Yourm5m5/Homedeck/pcb/pcb.png

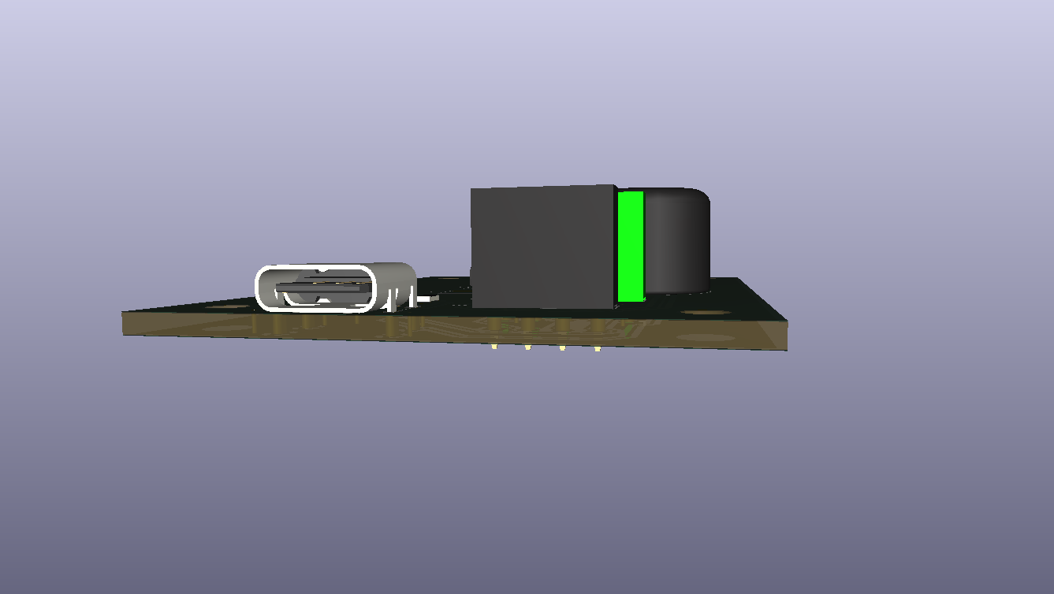
pcb/pcb.png
