Yourm5m5/Homedeck/README.md

# HomeDeck

**A 7" desk touchscreen for Home Assistant that shows your home at a glance and wakes up when you walk over.**


## What is HomeDeck?

HomeDeck is a 7" smart display that sits on a desk or bench and connects to Home Assistant over Wi-Fi. At a glance it shows the time, weather, calendar, energy use, and whether doors or windows are open. One tap controls lights, fans, air-con, scenes and music.

It's built around a Sunton ESP32-S3 7" touchscreen board, plus a **custom add-on PCB I designed in KiCad**. The add-on board provides protected USB-C power and three sensors:

- **LD2410C mmWave radar** notices when someone is in front of the panel (even sitting still) and wakes the screen
- **BH1750 light sensor** dims the screen automatically in a dark room
- **SHT40** reads room temperature and humidity and reports them back to Home Assistant

A small buzzer gives touch feedback and alerts. Everything sits in a 3D-printed enclosure I modelled in Fusion 360, tilted back 20° so it's easy to read and tap from a chair.

---

## Why I built it

I use Home Assistant at home, but controlling anything means pulling out my phone, unlocking it and opening an app, which is often slower than walking to the light switch. I wanted something that's **always on and always in the same place**: glance to see what's going on, tap once to change it.

You can buy smart displays, but most are locked to one company's ecosystem, rely on the cloud, and can't be customized. HomeDeck runs **locally** through ESPHome and Home Assistant, so it keeps working without the internet and shows exactly what I want.

I also wanted a project that would teach me real hardware skills: drawing a schematic, routing a two-layer PCB, modelling a multi-part enclosure and writing firmware, rather than just plugging modules together.

---

## Features

- 7" 800×480 capacitive touchscreen
- Controls lights, fans, AC, scenes and media through Home Assistant
- Shows time, weather, calendar, energy use and alerts
- Wakes automatically when someone walks up (mmWave presence)
- Auto-brightness from the ambient light sensor
- Reports room temperature and humidity to Home Assistant
- Buzzer for touch feedback, timers and doorbell alerts
- Fully local: ESPHome + LVGL, no cloud needed
- One USB-C cable for power

---

## How it works

The Sunton board's ESP32-S3 drives the display and runs ESPHome with an LVGL interface. The display uses almost every GPIO, so my add-on PCB connects through the few left on the board's expansion headers:

| Signal | Part | ESP32 pin | Header |
|---|---|---|---|
| I2C SDA / SCL | SHT40 + BH1750 | GPIO19 / GPIO20 | P3 (shared with touch, no address conflicts) |
| UART RX / TX | LD2410C | GPIO44 / GPIO43 | P1 |
| Presence output | LD2410C | GPIO17 | P4 |
| Buzzer (via NPN transistor) | Piezo | GPIO18 | P4 |
| 5 V power in | USB-C | n/a | P1 |

---

## Custom PCB

Designed in KiCad: a ~60 × 45 mm two-layer board with power traces on the front, signals on the back, ground fill on both sides and stitching vias. It passes DRC with **0 errors**.

**Power input:** USB-C (5.1 kΩ CC resistors) → 2 A polyfuse → SMAJ5.0CA TVS diode → 10 µF + 100 nF decoupling.




---

## Enclosure

Modelled in Fusion 360 as four 3D-printed parts:

1. **Front bezel** holds the screen behind a 2 mm lip and has a sensor window at the top
2. **Back shell** has vent slots so the SHT40 reads room air instead of screen heat
3. **Base** (190 × 120 × 24 mm) holds the display at 20°, with space for the PCB inside
4. **Bottom plate** mounts the add-on PCB on standoffs and has rubber feet underneath






> Screen-related sizes are estimates and will be checked against the real Sunton board before the final print.

---

## Bill of materials

All parts from **AliExpress** except the custom PCB, which comes from **JLCPCB**. Prices are **approximate AUD** and change with sales, exchange rates and shipping, so check the listing before ordering. Many small parts only come in packs, so you'll have spares.

### Electronics

| # | Part | Qty | Approx. AUD |
|---|---|---|---|
| 1 | Sunton ESP32-8048S070**C** (7" 800×480, ESP32-S3, capacitive touch) | 1 | $70.00 |
| 2 | HLK-LD2410C 24 GHz mmWave presence sensor | 1 | $6.00 |
| 3 | SHT40 temperature/humidity breakout module | 1 | $4.50 |
| 4 | BH1750 (GY-302) light sensor module | 1 | $3.00 |
| 5 | Passive piezo buzzer 12 mm (pack of 10) | 1 pack | $3.00 |
| 6 | MMBT3904 NPN transistor, SOT-23 (pack of 100) | 1 pack | $2.50 |
| 7 | USB-C 6-pin power-only socket (pack of 10) | 1 pack | $3.00 |
| 8 | 2 A polyfuse, 1812 (pack of 20) | 1 pack | $3.00 |
| 9 | SMAJ5.0CA TVS diode (pack of 50) | 1 pack | $3.00 |
| 10 | 0805 resistor + capacitor sample kit | 1 kit | $8.00 |
| 11 | 1.25 mm 4-pin connectors + pre-crimped cables | 1 set | $5.00 |
| 12 | 2.54 mm female header strips | 1 pack | $2.50 |
| 13 | Custom PCB, 5 pcs + shipping (**JLCPCB**) | 1 order | $18.00 |
| | **Electronics subtotal** | | **$131.50** |

### Enclosure

| # | Part | Qty | Approx. AUD |
|---|---|---|---|
| 14 | PETG filament (~300 g of a 1 kg roll) | 1 | $8.00 |
| 15 | M3 brass heat-set inserts (pack of 50) | 1 pack | $7.00 |
| 16 | M3 screw assortment (M3×6, M3×16) | 1 kit | $8.00 |
| 17 | Self-adhesive rubber feet | 1 pack | $3.00 |
| | **Enclosure subtotal** | | **$26.00** |

### Power

| # | Part | Qty | Approx. AUD |
|---|---|---|---|
| 18 | USB-C power supply, 5 V / 3 A | 1 | $10.00 |
| 19 | USB-C cable, 1 m | 1 | $4.00 |
| | **Power subtotal** | | **$14.00** |

### Total

| | AUD |
|---|---|
| Electronics | $131.50 |
| Enclosure | $26.00 |
| Power | $14.00 |
| **Estimated total** | **≈ $171.50** |

---

## Changes after review

The first review asked for better firmware documentation and an exploded view. What changed:

Firmware: commented every section of homedeck.yaml and wrote FIRMWARE.md, explaining each sensor (what it does, how it's read, how it's used) and how every LVGL element is wired to Home Assistant, with code snippets and diagrams
Exploded view: built a full assembly in Fusion 360 with every component and screw, plus ASSEMBLY.md
Design fix found along the way: the exploded view showed the radar and light sensor had nowhere to mount, so I added a sensor bay behind the top bezel (bezel 116 → 128 mm) and an SHT40 cradle with its own vents in the back shell

---

## Acknowledgements

- Sunton pinout info from [ESP3D](https://esp3d.io/esp3d-tft/version_1x/hardware/esp32-s3/sunton-70-8048/) and [Blakadder's templates](https://templates.blakadder.com/sunton_ESP32-8048S070.html)
- Built with [KiCad](https://www.kicad.org/), [Fusion 360](https://www.autodesk.com/products/fusion-360), [ESPHome](https://esphome.io/) and [Home Assistant](https://www.home-assistant.io/)
- AI assistance (Claude) was used for planning, guidance, diagrams and a reference enclosure model
