Yourm5m5/Homedeck/homedeck_assembly.step

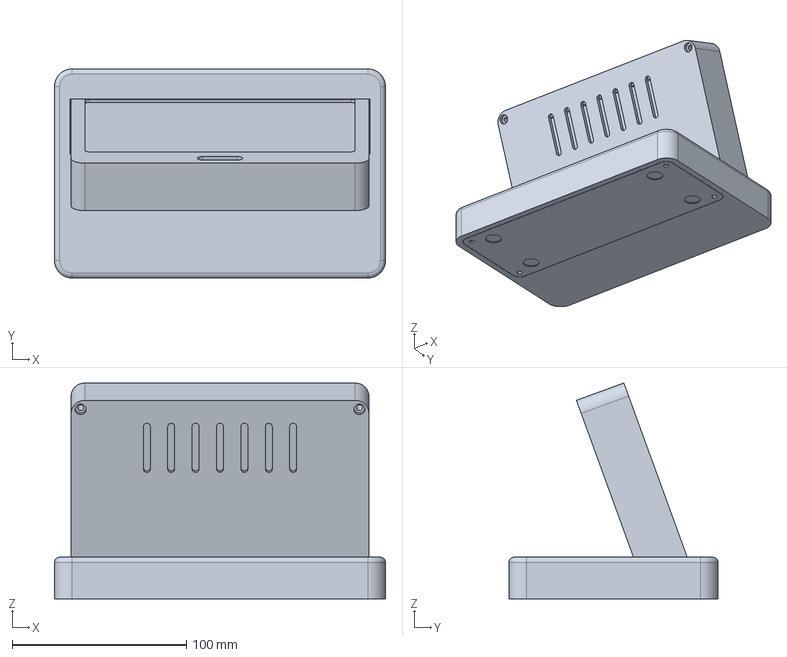
[picture p2: CAD file, 2026-10-11]
homedeck_assembly.step
190.0 x 120.0 x 124.0 mm
