Yourm5m5/Homedeck/Cad/Step/homedeck_front_bezel.step

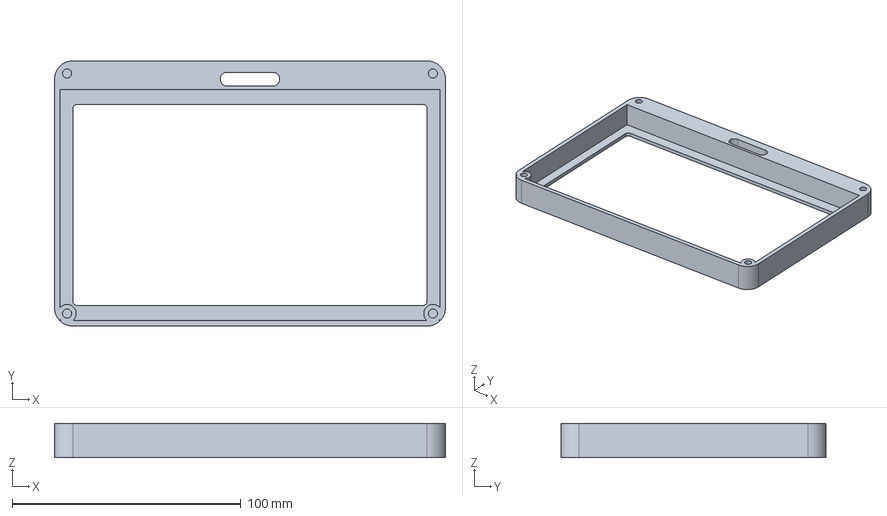
[picture p3: CAD file, 2026-10-11]
Cad/Step/homedeck_front_bezel.step
171.0 x 116.0 x 15.0 mm
