Yourm5m5/Homedeck/Cad/Stl/homedeck_back_shell.stl

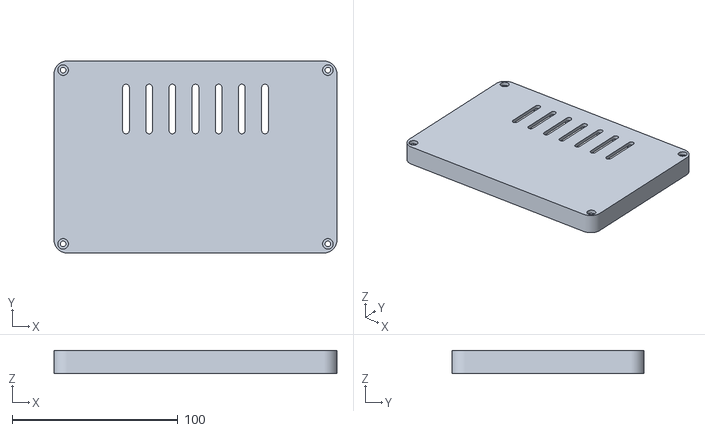
[picture p4: CAD file, 2026-10-11]
Cad/Stl/homedeck_back_shell.stl
171.0 x 116.0 x 14.0
