Yourm5m5/Homedeck/pcb/.stl

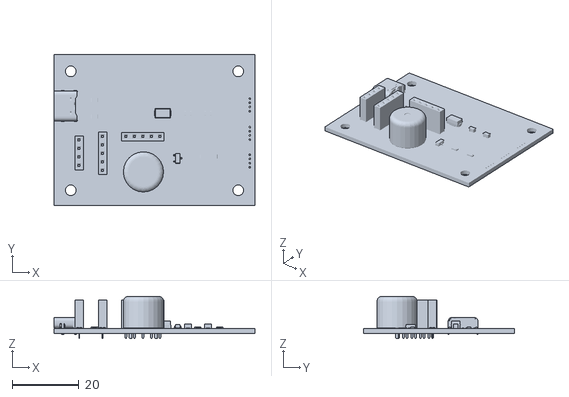
[picture p5: CAD file, 2026-10-18]
pcb/.stl
60.0 x 45.0 x 12.6
