Yourm5m5/Homedeck/homedeck_bottom_plate.step

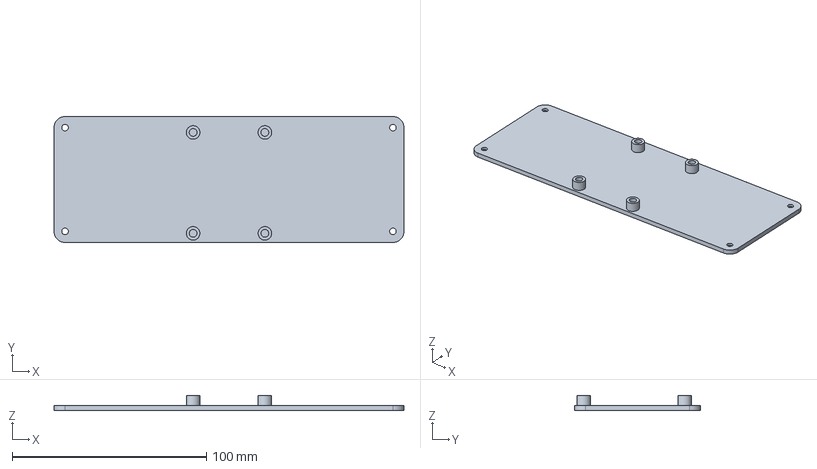
[picture p6: CAD file, 2026-10-11]
homedeck_bottom_plate.step
180.4 x 64.9 x 7.50 mm
