Yourm5m5/Homedeck/homedeck_base.step

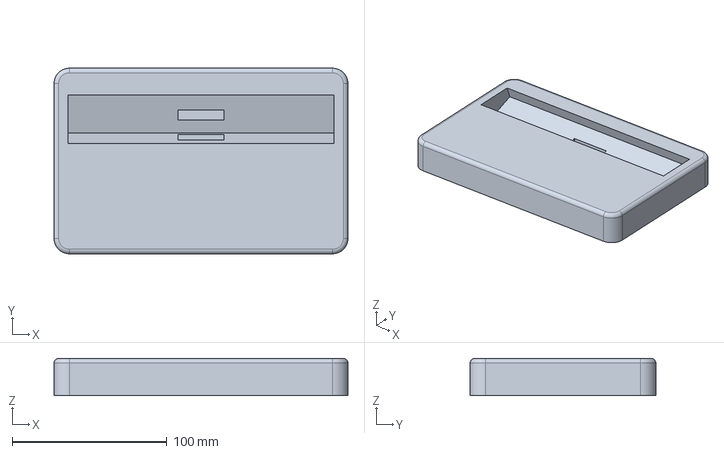
[picture p7: CAD file, 2026-10-11]
homedeck_base.step
190.0 x 120.0 x 24.0 mm
