Yourm5m5/Homedeck/(list of files, cad)

Other CAD files:
pcb/.step
Cad/Stl/homedeck_assembly.stl
Cad/Stl/homedeck_base.stl
Cad/Stl/homedeck_bottom_plate.stl
