Yourm5m5/Homedeck/JOURNAL.md

# HomePanel Journal

A 7" wall-mounted Home Assistant touchscreen that shows my home at a glance and wakes when I walk up.

---

## Day 1 – 11 Oct 2026
**Time spent:** ~6 hours

### What I did
- Brainstormed project ideas for Hack Club Forge 
- Picked a **Home Assistant touchscreen panel** because it can both control my home *and* show info. Example:
  

- First planned a 5" screen, then upgraded to **7"** for more room for controls. 7" is the biggest an ESP32-S3 can drive smoothly
- Chose the **Sunton ESP32-8048S070C** (7" 800×480, capacitive touch) as the main board
- Planned a custom add-on PCB with:
  - LD2410C mmWave sensor → wakes screen when someone walks up
  - SHT40 → temperature & humidity
  - BH1750 → auto screen brightness
  - Buzzer → touch feedback & alerts
  - USB-C power input with protection
- Made a full parts list (estimated total ~$120–185 AUD)
- Created the project on Forge and set up this repo

### Decisions
| Decision | Why |
|---|---|
| ESP32-S3 over Raspberry Pi | More of a real hardware project, lower power, instant boot |
| 7" over 5" | Fits a 3×3 grid of controls + clock/weather |
| ESPHome + LVGL | Connects natively to Home Assistant, no MQTT needed |

### Problems / things to check
- The display uses most of the ESP32's pins, so I need to check the Sunton pinout for free GPIOs for I2C + UART
- Need exact screen dimensions before designing the enclosure

### Next steps
- [ ] Find the Sunton board pinout
- [ ] Draw a block diagram of how everything connects
- [ ] Start the schematic in KiCad

### What I did after
- Drew the full schematic in KiCad: USB-C power input with polyfuse + TVS protection,
  connectors to the Sunton board, SHT40/BH1750/LD2410C sensor sockets, buzzer driver
- Assigned footprints (0805 passives, SOT-23 transistor, PicoBlade connectors)
- Laid out a ~60×45mm 2-layer PCB with 4 M3 mounting holes
- Routed power on the front layer (0.8mm) and signals on the back (0.3mm)
- Added GND fills on both layers + stitching vias
- Fixed all DRC errors → **0 errors**
- Exported Gerbers and got a JLCPCB quote

### Problems I solved
- Shield pad and a ground island weren't connected → added stitching vias
- Traces too wide for USB-C pads → used 0.4mm near the connector

### Images



### Next steps
- [ ] Design the enclosure
- [ ] Start the ESPHome firmware

## Day 2 – 12 Oct 2026: Enclosure CAD (Fusion 360)
**Time spent:** 10 hours (All-nighter. I was bored)

### What I did
- Designed the full HomeDeck desk-stand enclosure in Fusion 360
- Started from a concept sketch + a dimensioned reference drawing (made with AI help),
  then modelled every part myself in Fusion
- Set up **user parameters** for the screen size, so I can update everything
  once I measure the real Sunton board
- Modelled 4 parts:
  1. **Front bezel**: screen pocket with a 2 mm lip, 155 × 88 viewing window,
     26 × 6 sensor window for the light + mmWave sensors, M3 screw bosses
  2. **Back shell**: vent slots so the SHT40 reads room air instead of screen heat,
     cable exit at the bottom, counterbored screw holes
  3. **Base**: 190 × 120 × 24 mm with a slot that holds the display at a **20° tilt**,
     hollow underneath for the add-on PCB, cable tunnel, USB-C cutout at the back
  4. **Bottom plate**: 4 standoffs for the add-on PCB, screws into the base, rubber-foot recesses
- Put it all together in an assembly to check everything fits

### Decisions
| Decision | Why |
|---|---|
| Desk stand instead of wall mount | Easier to set up, no wall drilling, can move it around |
| 20° tilt | Comfortable to read and tap from a desk |
| PCB in the base | Keeps weight low so it doesn't tip when tapping the screen |
| Heat-set inserts for all screws | Stronger than screwing into plastic, can open it many times |
| Parametric design | Real screen sizes are still unknown, so this makes changes quick |

### Problems / what I learned
- [e.g. the tilted slot was tricky. Had to sketch on an angled plane]
- [e.g. learned how to use Shell, Fillet and Joints in Fusion]
- [anything that broke or you had to redo]

### Images





### Still to check
- Screen sizes are placeholders: confirm against the real Sunton board
- Line up the base's USB-C hole with J1 on the add-on PCB

### Next steps
- [ ] Start the ESPHome firmware + dashboard UI - I will start the code once I have the PCB 

## Day 3 – 13/10/2026: Firmware (ESPHome + LVGL)
Time spent: ~5 hours

What I did
- Wrote the HomeDeck firmware as one ESPHome YAML file
- Set up the Sunton board's 7" RGB display (800x480) and GT911 touchscreen
- Built 4 dashboard pages with LVGL and a nav bar at the bottom:
  - Home: big clock, date, outdoor weather, room temp and humidity
  - Rooms: tap tiles to toggle lights and the fan; tiles turn yellow when on
    and stay in sync with Home Assistant
  - Climate: drag a dial to set the air-con temperature
  - Media: now playing, prev / play-pause / next, volume slider
- Added my add-on PCB sensors:
  - SHT40: room temperature and humidity, sent to Home Assistant
  - BH1750: auto-brightness (dim at night, bright in daylight)
  - LD2410C: screen wakes when someone walks up, turns off 45 s after they leave
  - Buzzer: click on button presses, plus a "play_tone" action for doorbell alerts

Decisions
- ESPHome instead of Arduino: it connects to Home Assistant natively and the
  LVGL UI can be written in YAML
- Used the LD2410C's OUT pin (GPIO17) to wake the screen because it's instant;
  the UART data still goes to Home Assistant as a presence sensor
- Turned off serial logging because the LD2410C uses UART0 (GPIO43/44), so
  updates happen over Wi-Fi (OTA) after the first flash

Problems / what I learned
- The display needs exact RGB timing values (porches, pulse widths, pixel clock)
- Learned how LVGL pages, styles and flex layouts work
- Had to allow the device to perform Home Assistant actions before the buttons worked



Still to test (once parts arrive)
- Display timings on the real board
- LD2410C sensitivity and the 45 s sleep timer
- Auto-brightness range

Next steps
- [ ] Flash and test on the real board
- [ ] Tune the UI colours and layout
