Yourm5m5/Homedeck/pcb/pcb.kicad_pcb

## KiCad design pcb/pcb.kicad_pcb (2026-10-10)

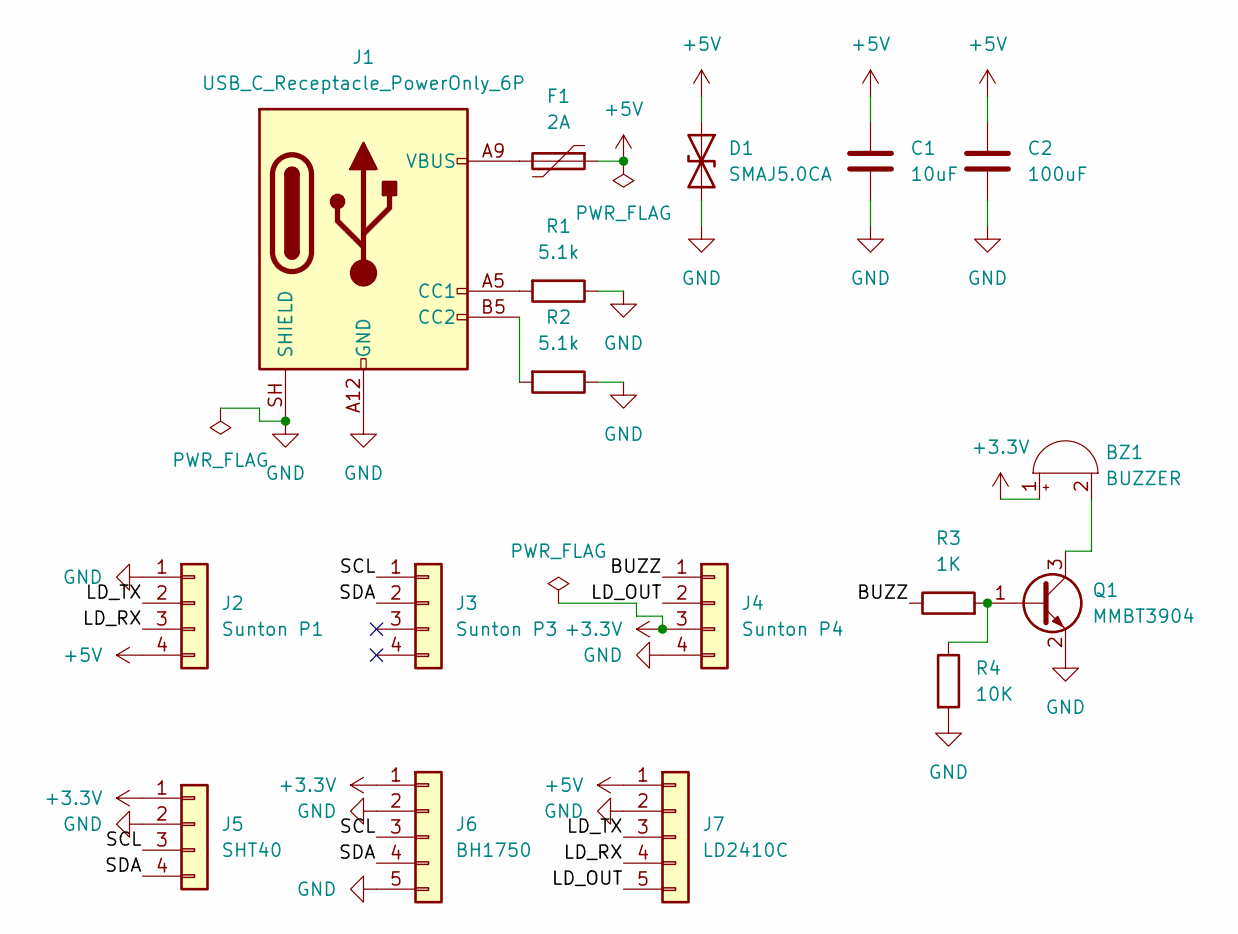
[picture p8: schematic pcb.kicad_sch]

Parts:
BZ1: BUZZER; Buzzer_12x9.5RM7.6
C1: 10uF; C_0805_2012Metric
C2: 100uF; C_0805_2012Metric
D1: SMAJ5.0CA; D_SMA
F1: 2A; Fuse_1812_4532Metric
J1: USB_C_Receptacle_PowerOnly_6P; USB_C_Receptacle_GCT_USB4125-xx-x-0190_6P_TopMnt_Horizontal
J2: Sunton P1; Molex_PicoBlade_53047-0410_1x04_P1.25mm_Vertical
J3: Sunton P3; Molex_PicoBlade_53047-0410_1x04_P1.25mm_Vertical
J4: Sunton P4; Molex_PicoBlade_53047-0410_1x04_P1.25mm_Vertical
J5: SHT40; PinSocket_1x04_P2.54mm_Vertical
J6: BH1750; PinSocket_1x05_P2.54mm_Vertical
J7: LD2410C; PinSocket_1x05_P2.54mm_Vertical
Q1: MMBT3904; SOT-23
R1, R2: 5.1k; R_0805_2012Metric
R3: 1K; R_0805_2012Metric
R4: 10K; R_0805_2012Metric

Connections:
+3.3V: BZ1.1 (+), J4.3, J5.1, J6.1
+5V: C1.1, C2.1, D1.1 (A1), F1.1, J2.4, J7.1
/BUZZ: J4.1, R3.1
/LD_OUT: J4.2, J7.5
/LD_RX: J2.3, J7.4
/LD_TX: J2.2, J7.3
/SCL: J3.1, J5.3, J6.3
/SDA: J3.2, J5.4, J6.4
GND: C1.2, C2.2, D1.2 (A2), J1.A12 (GND), J1.B12 (GND), J1.SH (SHIELD), J2.1, J4.4, J5.2, J6.2, J6.5, J7.2, Q1.2 (E), R1.1, R2.1, R4.2
unnamed: BZ1.2 (-), Q1.3 (C)
unnamed: F1.2, J1.A9 (VBUS), J1.B9 (VBUS)
unnamed: J1.A5 (CC1), R1.2
unnamed: J1.B5 (CC2), R2.2
unnamed: Q1.1 (B), R3.2, R4.1

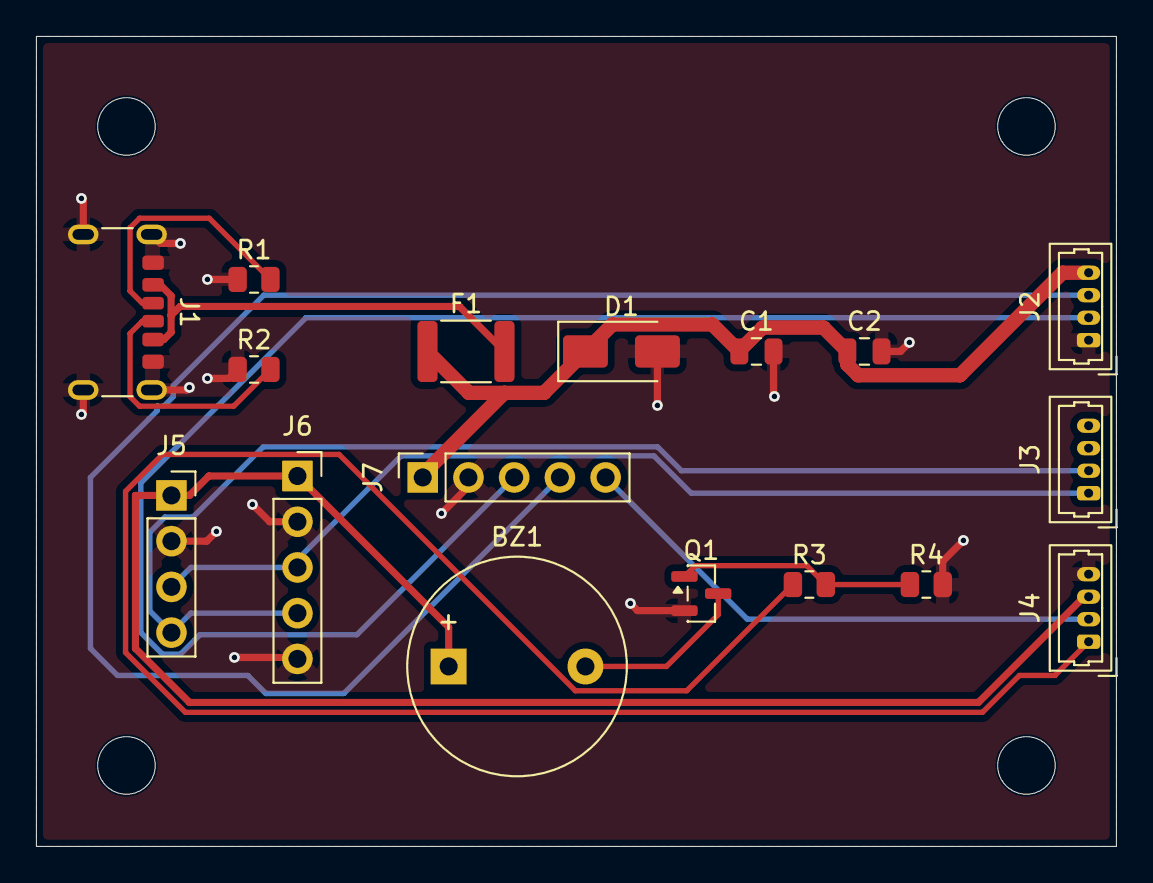
[picture p9: board pcb.kicad_pcb from above]

Board: 2 copper layers, 60.0 x 45.0 mm, 17 parts (0 on the bottom side), 14 nets.
