Yourm5m5/Homedeck/(commit log)

2026-10-10 pcb
    w
2026-10-18 Remove exploded view image from ASSEMBLY.md
    Removed the exploded view image from the assembly guide.
2026-10-18 Document changes after review in README
    Added detailed changes after review, including firmware documentation and assembly updates.
